Dioxgen/3D-Printed-Focuser/README.md

# 3D打印颗粒对焦器

###### 【Designed By Dioxgen】

## 概述

这是一款基于 **SOLIDWORKS** 设计的 3D 打印**暗房颗粒对焦（放大）器**。

效果图_W





DSC_2796.MOV_20251020_224942.991

## 制作

### 准备：

#### 主体：

将 `STL` 文件夹中的 4 个组件全部 3D 打印。

以下是示例工艺：

> 黑色 PETG
>
> `15%` 填充

#### 目镜：

关键词：眼夹式目镜放大镜

规格：`5~10X` 放大

MagnifyingGlass

#### 镜片：

`3x3cm`，厚 `1mm` 平面镜。

#### 磨砂片：

定制 `Φ=30mm`，厚 `2mm` 圆形亚克力**单面**磨砂片。

DSC_2791.MOV_20251020_224832.562

### 组装：

1）将 `磨砂片` 通过少量胶水固定在 `目镜座` 较**大**开口的部位。

> 注：磨砂面朝**外**。

2）将 `目镜` 卡入、胶水固定至 `目镜座` 另一头。

3）将 `镜片` 通过少量胶水固定在 `镜片平台` 内。

4）将 `镜片平台` 和 `磨砂屏-目镜座` 嵌入 `支架` 中，随后，将这个装配体**嵌入** `底座`。

> 注：底座与镜片平台已设置配合间隙，其余部分可以稍作打磨后安装。以上组装计顺序，否则胶水挥发物可能影响光学面表现。

### 原理：

利用**平面镜反射**原理，将放大镜头产生的实像反射至磨砂片处，同时保持总体光路**长度不变**。

> 这个例子中光路长度为 `49.01mm`。

示意图
