Dioxgen/3D-Printed-Focuser/STL/底座.STL

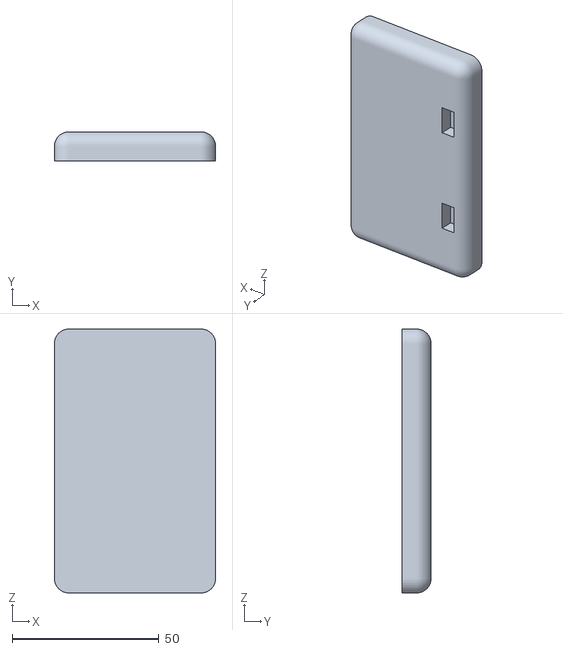
[picture p1: CAD file, 2026-11-06]
STL/底座.STL
55.0 x 10.0 x 90.0
