Dioxgen/3D-Printed-Focuser/STL/镜片平台.STL

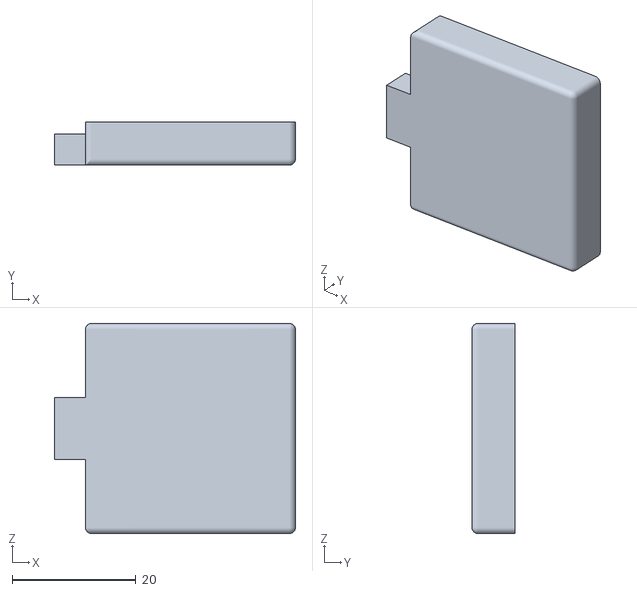
[picture p2: CAD file, 2026-11-06]
STL/镜片平台.STL
39.0 x 7.00 x 34.0
