Dioxgen/3D-Printed-Focuser/工程/颗粒对焦器_装配体.SLDASM

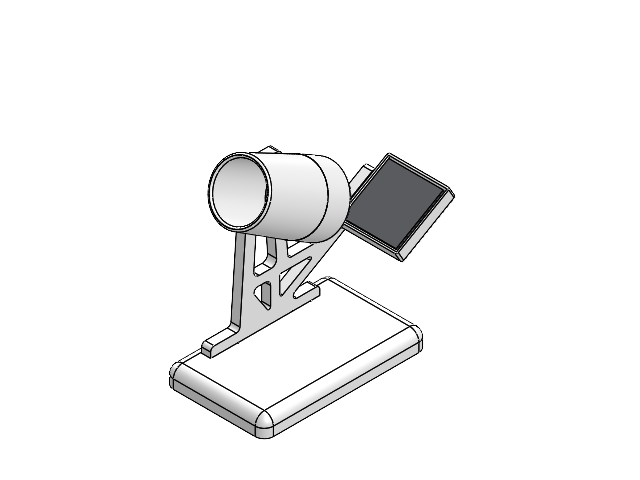
[picture p3: CAD file, 2026-11-06]
工程/颗粒对焦器_装配体.SLDASM
底座
支架
镜片平台
磨砂屏-目镜座
镜面
单面磨砂片
