Dioxgen/3D-Printed-Focuser/(list of files, cad)

Other CAD files:
工程/镜片平台.SLDPRT
工程/底座.SLDPRT
