Dioxgen/3D-Printed-Focuser/(notices)

Notices in the files:
README.md:
License: GPL
